fablabnk/blot/(list of files, drawings)

Other design files:
hardware/motor-control-board/circuit/controller_EasyEDA/blot-control-board.easyEDA-layout.json
hardware/motor-control-board/circuit/controller_EasyEDA/blot-control-board.easyEDA-schematic.json
