fablabnk/blot/hardware/motor-control-board/circuit/controller_Kicad/controller_Kicad.kicad_pcb

## KiCad design hardware/motor-control-board/circuit/controller_Kicad/controller_Kicad.kicad_pcb (2025-01-09)

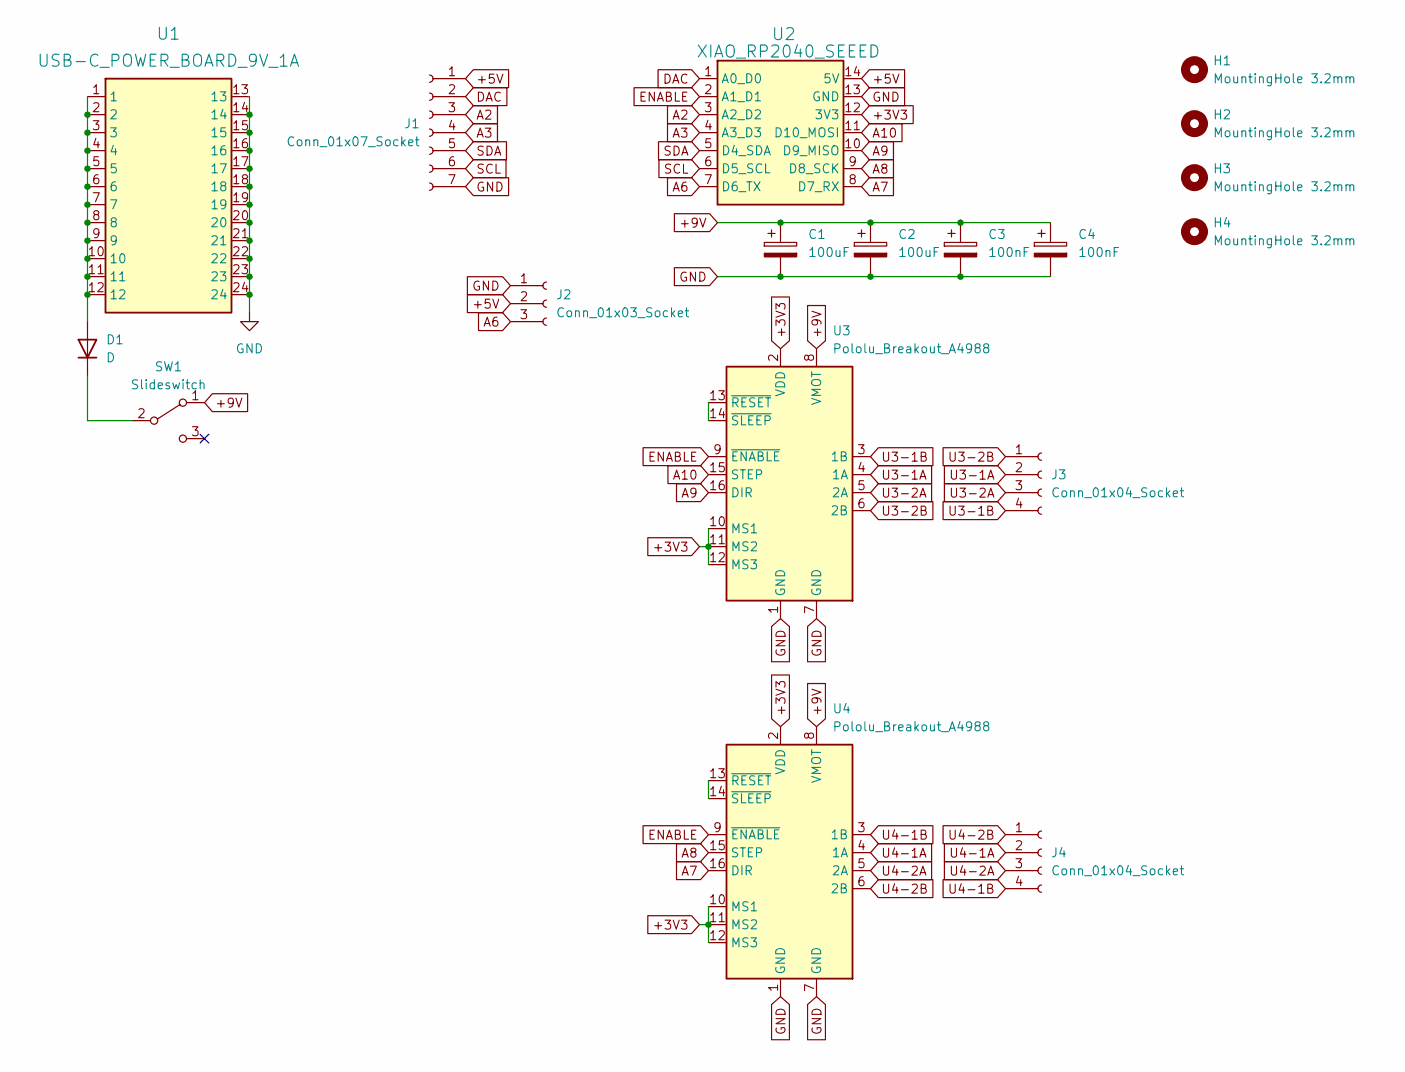
[picture p5: schematic controller_Kicad.kicad_sch]

Parts:
C1, C2: 100uF; CP_Radial_D8.0mm_P2.50mm_Horizontal_Mirrored
C3, C4: 100nF; C_Disc_D4.3mm_W1.9mm_P5.00mm
D1: D; D_DO-35_SOD27_P7.62mm_Horizontal
H1, H2, H3, H4: MountingHole 3.2mm; HOLE-3.2MM
J1: Conn_01x07_Socket; PinSocket_1x07_P2.54mm_Vertical
J2: Conn_01x03_Socket; PinSocket_1x03_P2.54mm_Vertical
J3, J4: Conn_01x04_Socket; PinHeader_1x04_P2.54mm_Horizontal
SW1: Slideswitch; SW_Slide-03_Wuerth-WS-SLTV_10x2.5x6.4_P2.54mm_Pins_1_2_Reve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
U1: USB-C_POWER_BOARD_9V_1A
U2: XIAO_RP2040_SEEED
U3, U4: Pololu_Breakout_A4988; Pololu_Breakout-16_15.2x20.3mm

Connections:
+3V3: U2.12 (3V3), U3.2 (VDD), U3.10 (MS1), U3.11 (MS2), U3.12 (MS3), U4.2 (VDD), U4.10 (MS1), U4.11 (MS2), U4.12 (MS3)
+5V: J1.1, J2.2, U2.14 (5V)
+9V: C1.1, C2.1, C3.1, C4.1, SW1.1 (A), U3.8 (VMOT), U4.8 (VMOT)
A2: J1.3, U2.3 (A2_D2)
A3: J1.4, U2.4 (A3_D3)
A6: J2.3, U2.7 (D6_TX)
A7: U2.8 (D7_RX), U4.16 (DIR)
A8: U2.9 (D8_SCK), U4.15 (STEP)
A9: U2.10 (D9_MISO), U3.16 (DIR)
A10: U2.11 (D10_MOSI), U3.15 (STEP)
DAC: J1.2, U2.1 (A0_D0)
ENABLE: U2.2 (A1_D1), U3.9 (~ENABLE), U4.9 (~ENABLE)
GND: C1.2, C2.2, C3.2, C4.2, J1.7, J2.1, U1.13, U1.14, U1.15, U1.16, U1.17, U1.18, U1.19, U1.20, U1.21, U1.22, U1.23, U1.24, U2.13 (GND), U3.1 (GND), U3.7 (GND), U4.1 (GND), U4.7 (GND)
unnamed: D1.2 (A), U1.1, U1.2, U1.3, U1.4, U1.5, U1.6, U1.7, U1.8, U1.9, U1.10, U1.11, U1.12
unnamed: D1.1 (K), SW1.2 (B)
unnamed: U3.13 (~RESET), U3.14 (~SLEEP)
unnamed: U4.13 (~RESET), U4.14 (~SLEEP)
SCL: J1.6, U2.6 (D5_SCL)
SDA: J1.5, U2.5 (D4_SDA)
U3-1A: J3.2, U3.4 (1A)
U3-1B: J3.4, U3.3 (1B)
U3-2A: J3.3, U3.5 (2A)
U3-2B: J3.1, U3.6 (2B)
U4-1A: J4.2, U4.4 (1A)
U4-1B: J4.4, U4.3 (1B)
U4-2A: J4.3, U4.5 (2A)
U4-2B: J4.1, U4.6 (2B)

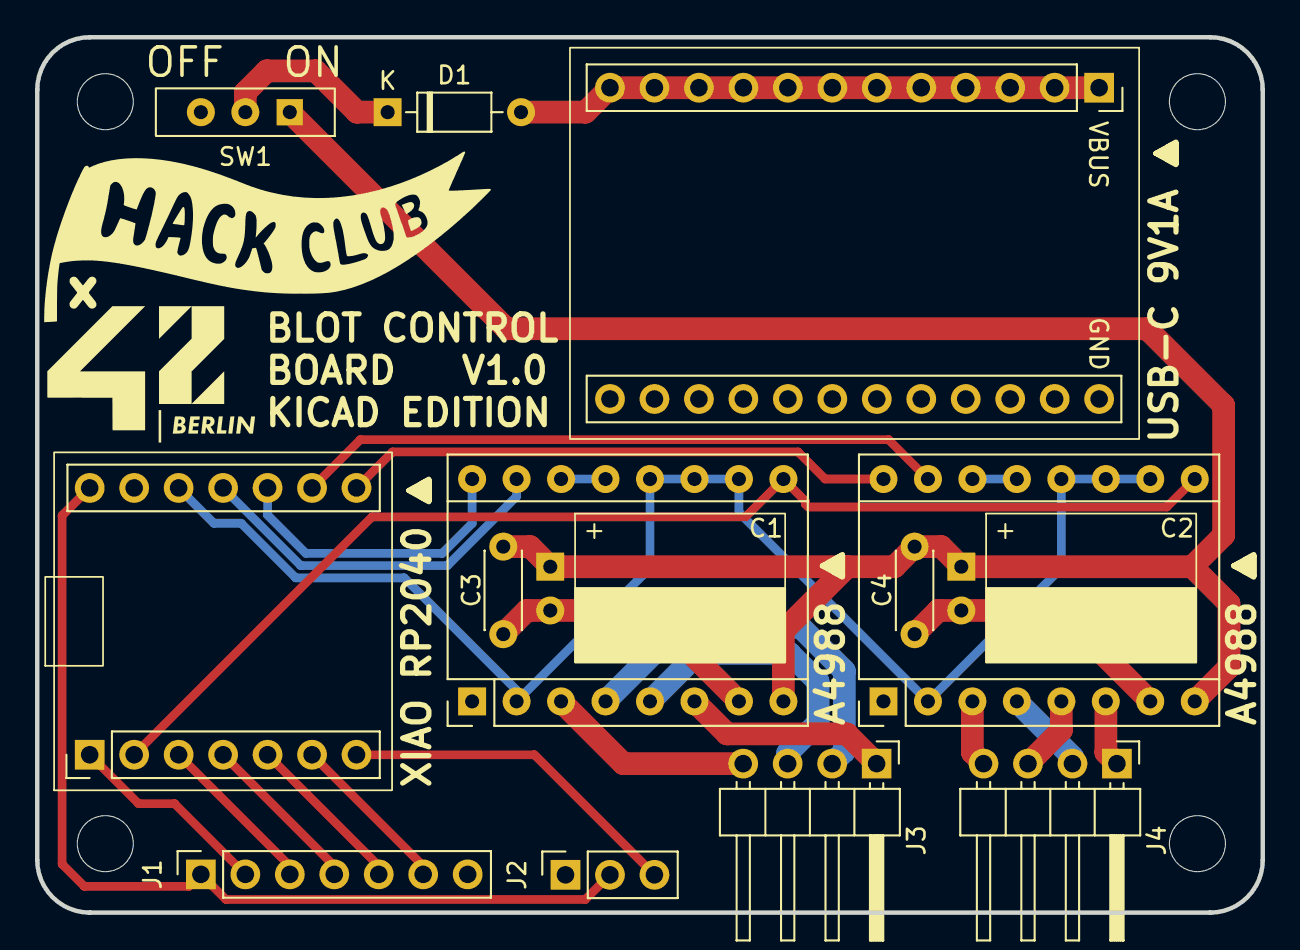
[picture p6: board controller_Kicad.kicad_pcb from above]

Board: 2 copper layers, 70.0 x 50.0 mm, 18 parts (0 on the bottom side), 27 nets.
