fablabnk/blot/(commit log)

2025-01-05 added new README and controller_Kicad project in /hardware
    [blot-control-board.easyEDA-layout.json, blot-control-board.easyEDA-schematic.json, bom.csv, controller_Kicad.kicad_pcb, controller_Kicad.kicad_sch, designators.csv, positions.csv]
2025-01-09 re-laid out and re-routed PCB - V1.0 ready for production
    [CYPD-3177 Breakout-BOM.csv, CYPD-3177 Breakout.kicad_pcb, CYPD-3177 Breakout.kicad_sch, bom.csv, controller_Kicad.kicad_pcb, controller_Kicad.kicad_sch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]
2025-01-09 removed motor board temp kicad projects
    [bom.csv, controller_Kicad.kicad_pcb, controller_Kicad.kicad_sch, designators.csv, positions.csv]
2025-01-12 edited USB-C connector footprint to match chosen component - plus other misc DRC fixes - ready for production - some manual adjustment still needed (U1 orientation, USB-C position wrong etc
    [CYPD-3177 Breakout.kicad_pcb, CYPD-3177 Breakout.kicad_sch, bom.csv]
2025-06-07 add motors connection image
2025-06-07 update kicad project files to version 9
    [controller_Kicad.kicad_sch]
